sofia-kirilov/starbie/BOM.csv

Item | Qty | Est. cost each (USD) | Est. total (USD) | Link | Notes
Seeed XIAO ESP32-C3 | 1 | 4.99 | 4.99 | https://www.seeedstudio.com/Seeed-XIAO-ESP32C3-p-5431.html | Microcontroller (U1)
0.96 in 128x64 I2C OLED (SSD1306) | 1 | 2.50 | 2.50 | https://www.amazon.com/dp/B0GBVWBWCR | Screen (J1); pin order must be GND VCC SCL SDA
MPU6050 (GY-521) module | 1 | 2.29 | 2.29 | https://www.amazon.com/dp/B0943SGP34 | Motion sensor (J2)
DHT11 sensor (bare 4-pin) | 1 | 3.33 | 3.33 | https://www.amazon.com/dp/B0BLG7R99R | Temperature/humidity (U2); optional
10k ohm resistor | 1 | 0.05 | 0.05 | https://www.amazon.com/dp/B0B4JFPHTW | DHT11 pull-up (R1); optional with DHT11
Cherry MX-style switch | 2 | 0.18 | 0.36 | https://www.amazon.com/dp/B0FQP8VYX4 | Buttons (SW1 and SW2)
MX keycap | 2 | 0.60 | 1.20 | https://www.amazon.com/dp/B0CQ2VLMVY | Optional
PCB (2-layer) | 1 | 10.00 | 10.00 | https://jlcpcb.com/ | Upload gerbers.zip; price includes estimated shipping
Total |  |  | 24.72
